UCSD-E4E/smartfin-pcba-v3/README.md

# smartfin-pcba-v3
Smartfin PCB v3

## Toolchain
Uses Altium 23.6.0
