UCSD-E4E/smartfin-pcba-v3/(list of files, drawings)

Other design files:
PCB1.PcbDoc
Smartfin Main PCBA Control.SchDoc
Smartfin Main PCBA Motion.SchDoc
Smartfin Main PCBA Temp Sensor Connection.SchDoc
Smartfin Main PCBA Top Level.SchDoc
Smartfin Main PCBA USB.SchDoc
Smartfin Main PCBA Wet Dry Sensor.SchDoc
Smartfin Main PCBA_Block Diagram.SchDoc
Smartfin Main PCBA_TOC.SchDoc
Smartfin TSoM.PrjPcb
