UCSD-E4E/smartfin-pcba-v3/(threads)

Thread 2 (2023-07-07):

Eval Board Layout/Pinout

ntlhui, 2023-07-07:
Pinout/pin mapping and BOM not defined, please document in this repository

ntlhui, 2025-02-10:
Blocked on Altium with UCSD Campus

ntlhui, 2025-02-24:
Completed

Closed 2025-02-24.

Thread 3 (2023-08-22):

A7 3v3 tolerance from VBUS

ntlhui, 2023-08-22:
VBUS is 5v0, A7 is only tolerant of 3v3.  Overvoltage condition, requires voltage divider.  Utilize 33k and 17k resistor in place of R11.

ntlhui, 2024-01-11:
Implemented as of c07e8e948fabdb6d2ca489cd0d26f0d3529893e8

HW Mod: https://github.com/UCSD-E4E/smartfin-pcba-v3/wiki/v3-HW-Mods#r11

Closed 2024-01-11.

Thread 4 (2023-08-22):

A4 3v3 tolerance from VBUS

ntlhui, 2023-08-22:
A4 is only tolerant of 3v3, VBUS provides 5v.

Temporary solution is to cut the trace supplying A4@41, bridge a 33k/17k divider to A4@41 from D4.1.

ntlhui, 2024-01-11:
https://github.com/UCSD-E4E/smartfin-pcba-v3/wiki/v3-HW-Mods#hwmod-12

Fixed as of c07e8e948fabdb6d2ca489cd0d26f0d3529893e8

Closed 2024-01-11.

Thread 10 (2023-11-14):

U2.5 is not connected

ntlhui, 2023-11-14:
Needs connection to GND.

HW Mod for Rev XA0: 30 AWG wire from U2.5 to U6.5

ntlhui, 2023-11-14:
Fixes in 1044dcdb435ddd5384c1d9268edb3c5c9df4f159

Closed 2023-11-14.

Thread 11 (2023-11-15):

Incorrect resistor values

ntlhui, 2023-11-15:
R34 should be 10k, currently shunt resistor
R35 should be 10k, currently shunt resistor
R36 should be 330, currently shunt resistor
R37 should be 10k, currently shunt resistor
R38 should be 10k, currently shunt resistor
R39 should be 10k, currently shunt resistor
R40 should be 100k, currently shunt resistor

ntlhui, 2023-11-15:
Designator	Value	Footprint	Populate	MPN	Manufacturer	Resistance	Checked	Desired Value
R18	ERA2ARB103X	RES_ERA2ARB103X	1	ERA-2ARB103X	Panasonic	1.00E+04	FALSE	120	RC0402FR-07120RL
R34	RC0402JR-070RL	RESC1005X40	1	RC0402JR-070RL	Yageo	0	FALSE	1.00E+04	RC0402FR-0710KL
R35	RC0402JR-070RL	RESC1005X40	1	RC0402JR-070RL	Yageo	0	FALSE	1.00E+04	RC0402FR-0710KL
R36	RC0402JR-070RL	RESC1005X40	1	RC0402JR-070RL	Yageo	0	FALSE	330	RC0402FR-07330RL
R37	RC0402JR-070RL	RESC1005X40	1	RC0402JR-070RL	Yageo	0	FALSE	1.00E+04	RC0402FR-0710KL
R38	RC0402JR-070RL	RESC1005X40	1	RC0402JR-070RL	Yageo	0	FALSE	1.00E+04	RC0402FR-0710KL
R39	RC0402JR-070RL	RESC1005X40	1	RC0402JR-070RL	Yageo	0	FALSE	1.00E+05	RC0402FR-07100KL
R40	RC0402JR-070RL	RESC1005X40	1	RC0402JR-070RL	Yageo	0	FALSE	1.00E+05	RC0402FR-07100KL

Closed 2024-01-11.

Thread 12 (2024-01-11):

BUG: Disconnected GND at Pin 42

ntlhui, 2024-01-11:
At ed2b962bcb73b9d9a61381cbb785bb0d32fab1f2
Pin 42 designated GND, confirmed on Tracker SoM datasheet
SCH indicates NC, build confirmed NC

ntlhui, 2024-01-11:
Recommend HW MOD:
jumper from U1.42 to U1.43

Closed 2024-01-11.

Thread 13 (2024-01-11):

BUG: D2 has the wrong driving resistor

ntlhui, 2024-01-11:
D2 is APT1608MGC (https://www.kingbrightusa.com/images/catalog/SPEC/APT1608MGC.pdf)
Vf is nominally 2.5V
If is nominally 20mA
Driving voltage is 3.3V
R12 is nominally 40 ohm, but is currently 120 ohm!

Replace with RC0402FR-0747RL

Closed 2024-01-11.

Thread 14 (2024-08-14):

Add test pads for 3.3V and 1.8V bus

MAnn223, 2024-08-14:
Need to add test pads for 3.3V and 1.8V for I2C bus to make debugging I2C easier

ntlhui, 2024-11-21:
@tbaskevitch is this something you would be interested in looking into?

Thread 15 (2024-08-19):

Check LiPo Battery

MAnn223, 2024-08-19:
Battery made a noise when being connected to PCB

ntlhui, 2025-04-26:
Resolved

Closed 2025-04-26.

Thread 18 (2025-04-22):

Validate wet/dry sensor

ntlhui, 2025-04-22:
Wet/dry sensor on XA0 with mods is not working

ntlhui, 2025-04-26:
Fixed

Closed 2025-04-26.

Thread 20 (2025-04-26):

Task: Build PCB to facilitate manual testing

ntlhui, 2025-04-26:
Switch board for shorting the following:

- Wet/Dry
- Reset
- Mode

Thread 24 (2025-05-14):

FR: Solder bridge resistor for U4.11 (FSYNC)

ntlhui, 2025-05-14:
Add a solder bridge/0 ohm resistor to connect U4.11 (FSYNC) to GND.  This allows us to re-wire FSYNC to something else later if we need to.

ntlhui, 2025-05-14:
This might also want a test point.

Thread 25 (2025-05-14):

FR: Solder bridge resistor for U4.9 (AD0/SD0)

ntlhui, 2025-05-14:
Add a solder bridge/0 ohm resistor to U4.9 (AD0/SD0) to allow re-wiring to something else.
