UCSD-E4E/smartfin-pcba-v3/(commit log)

2023-08-16 fix: Updates D1 layout
    [PCB1.PcbDoc, Smartfin Main PCBA Control.SchDoc, Smartfin TSoM.PrjPcb]
2023-08-22 remove gps schematic
2023-08-28 Cleaned up main schematic
    [Smartfin Main PCBA Control.SchDoc, Smartfin TSoM.PrjPcb]
2023-10-17 fix: Updates contact info
    [Smartfin TSoM.PrjPcb]
2023-10-17 fix: Updates schematic layout
    [Smartfin Main PCBA Control.SchDoc, Smartfin Main PCBA Top Level.SchDoc, Smartfin Main PCBA_TOC.SchDoc]
2023-11-07 fix: Designates TRACKER-TSOM as U1
    [Smartfin Main PCBA Control.SchDoc]
2023-11-07 fix: Fixes TP6 display
    [PCB1.PcbDoc]
2023-11-07 fix: Fixes J1.1 net name
    [PCB1.PcbDoc, Smartfin Main PCBA Temp Sensor Connection.SchDoc]
2023-11-07 fix: Renames J1.1 pad, moves TP16
    [PCB1.PcbDoc]
2023-11-07 fix: Corrected U7 footprint
    [PCB1.PcbDoc, Smartfin Main PCBA Control.SchDoc]
2023-11-07 fix: Updates magnetic reset layout
    [PCB1.PcbDoc, Smartfin Main PCBA Control.SchDoc]
2023-11-07 Save update
    [Smartfin TSoM.PrjPcb]
2023-11-14 fix: Fixes U2.5
    [PCB1.PcbDoc, Smartfin Main PCBA Wet Dry Sensor.SchDoc]
2023-11-21 fix: Updates all resistors, schematics, and layout
    [PCB1.PcbDoc, Smartfin Main PCBA Control.SchDoc, Smartfin Main PCBA Motion.SchDoc, Smartfin Main PCBA Temp Sensor Connection.SchDoc, Smartfin Main PCBA USB.SchDoc, Smartfin Main PCBA Wet Dry Sensor.SchDoc, Smartfin Main PCBA_Block Diagram.SchDoc, Smartfin TSoM.PrjPcb]
2023-11-21 fix: Fixes U10 symbol
    [Smartfin Main PCBA Motion.SchDoc]
2023-11-21 fix: updates toc, p1
    [PCB1.PcbDoc, Smartfin Main PCBA Control.SchDoc, Smartfin Main PCBA_TOC.SchDoc]
2023-11-21 fix: Updates project
    [Smartfin TSoM.PrjPcb]
2023-11-21 fix: Moves SS pins to notes
    [Smartfin Main PCBA USB.SchDoc, Smartfin Main PCBA Wet Dry Sensor.SchDoc]
2023-11-21 fix: Updates test points and U1
    [PCB1.PcbDoc, Smartfin Main PCBA Control.SchDoc, Smartfin Main PCBA Motion.SchDoc, Smartfin Main PCBA Temp Sensor Connection.SchDoc, Smartfin Main PCBA USB.SchDoc, Smartfin Main PCBA Wet Dry Sensor.SchDoc]
2023-11-21 fix: Updates U6 and U2 layout and revision
    [PCB1.PcbDoc, Smartfin Main PCBA Wet Dry Sensor.SchDoc]
2023-11-21 fix: Renames COM net
    [PCB1.PcbDoc, Smartfin Main PCBA Wet Dry Sensor.SchDoc]
2023-11-21 fix: Removes dangling ERC
    [Smartfin Main PCBA Control.SchDoc]
2023-11-22 fix: Updates ICM-20948 symbol and layout
    [PCB1.PcbDoc, Smartfin Main PCBA Control.SchDoc, Smartfin Main PCBA Motion.SchDoc, Smartfin TSoM.PrjPcb]
2023-11-22 fix: Updates J1 drivers
    [PCB1.PcbDoc, Smartfin Main PCBA Motion.SchDoc, Smartfin Main PCBA Temp Sensor Connection.SchDoc, Smartfin TSoM.PrjPcb]
2023-11-22 fix: Allowing IMU_SCL no driver - driven from R29.2
    [Smartfin Main PCBA Motion.SchDoc]
2023-11-22 fix: Allows MODE no driver due to pullup and TP11 driver
    [Smartfin Main PCBA Control.SchDoc]
2023-11-22 Updates all
    [PCB1.PcbDoc, Smartfin Main PCBA Wet Dry Sensor.SchDoc, Smartfin TSoM.PrjPcb]
2023-11-22 fix: Updates U1 SWD
    [PCB1.PcbDoc, Smartfin Main PCBA Control.SchDoc, Smartfin Main PCBA Wet Dry Sensor.SchDoc, Smartfin TSoM.PrjPcb]
2023-11-22 fix: Corrects WATER_MFG_TEST net name
    [PCB1.PcbDoc, Smartfin Main PCBA Wet Dry Sensor.SchDoc]
2023-11-22 fix: Fixes IMU_SDA net label
    [Smartfin Main PCBA Motion.SchDoc]
2023-11-22 fix: Fixes VBUS net label
    [Smartfin Main PCBA USB.SchDoc]
2023-11-22 fix: Removes dangling wire
    [Smartfin Main PCBA USB.SchDoc]
2023-11-22 fix: Allows Output Port to I/O pin violation
    U1.56 will be configured in SW as output
    [Smartfin Main PCBA Control.SchDoc]
2023-11-22 fix: Fixes net labels and USB Presence detection voltage levels
    [PCB1.PcbDoc, Smartfin Main PCBA Control.SchDoc, Smartfin Main PCBA Wet Dry Sensor.SchDoc, Smartfin TSoM.PrjPcb]
2023-11-22 fix: Ignores input port to i/o pin
    U1.39 is configured as input in software
    [Smartfin Main PCBA Control.SchDoc]
2023-11-22 fix: Ignores I/O/port mismatch errors on GPIO
    [Smartfin Main PCBA Control.SchDoc]
2023-11-22 fix: Removed managed job
    [Smartfin TSoM.PrjPcb]
2023-11-22 fix: Updates changes from Schematic
    [PCB1.PcbDoc]
2024-01-11 fix: Replaces R12 with 47 ohm
    Fixes #13
    [PCB1.PcbDoc, Smartfin Main PCBA Control.SchDoc]
